NCKiser/kiao/kiao-pcba/kiao-pcba.kicad_pcb

## KiCad design kiao-pcba/kiao-pcba.kicad_pcb (2024-02-06)

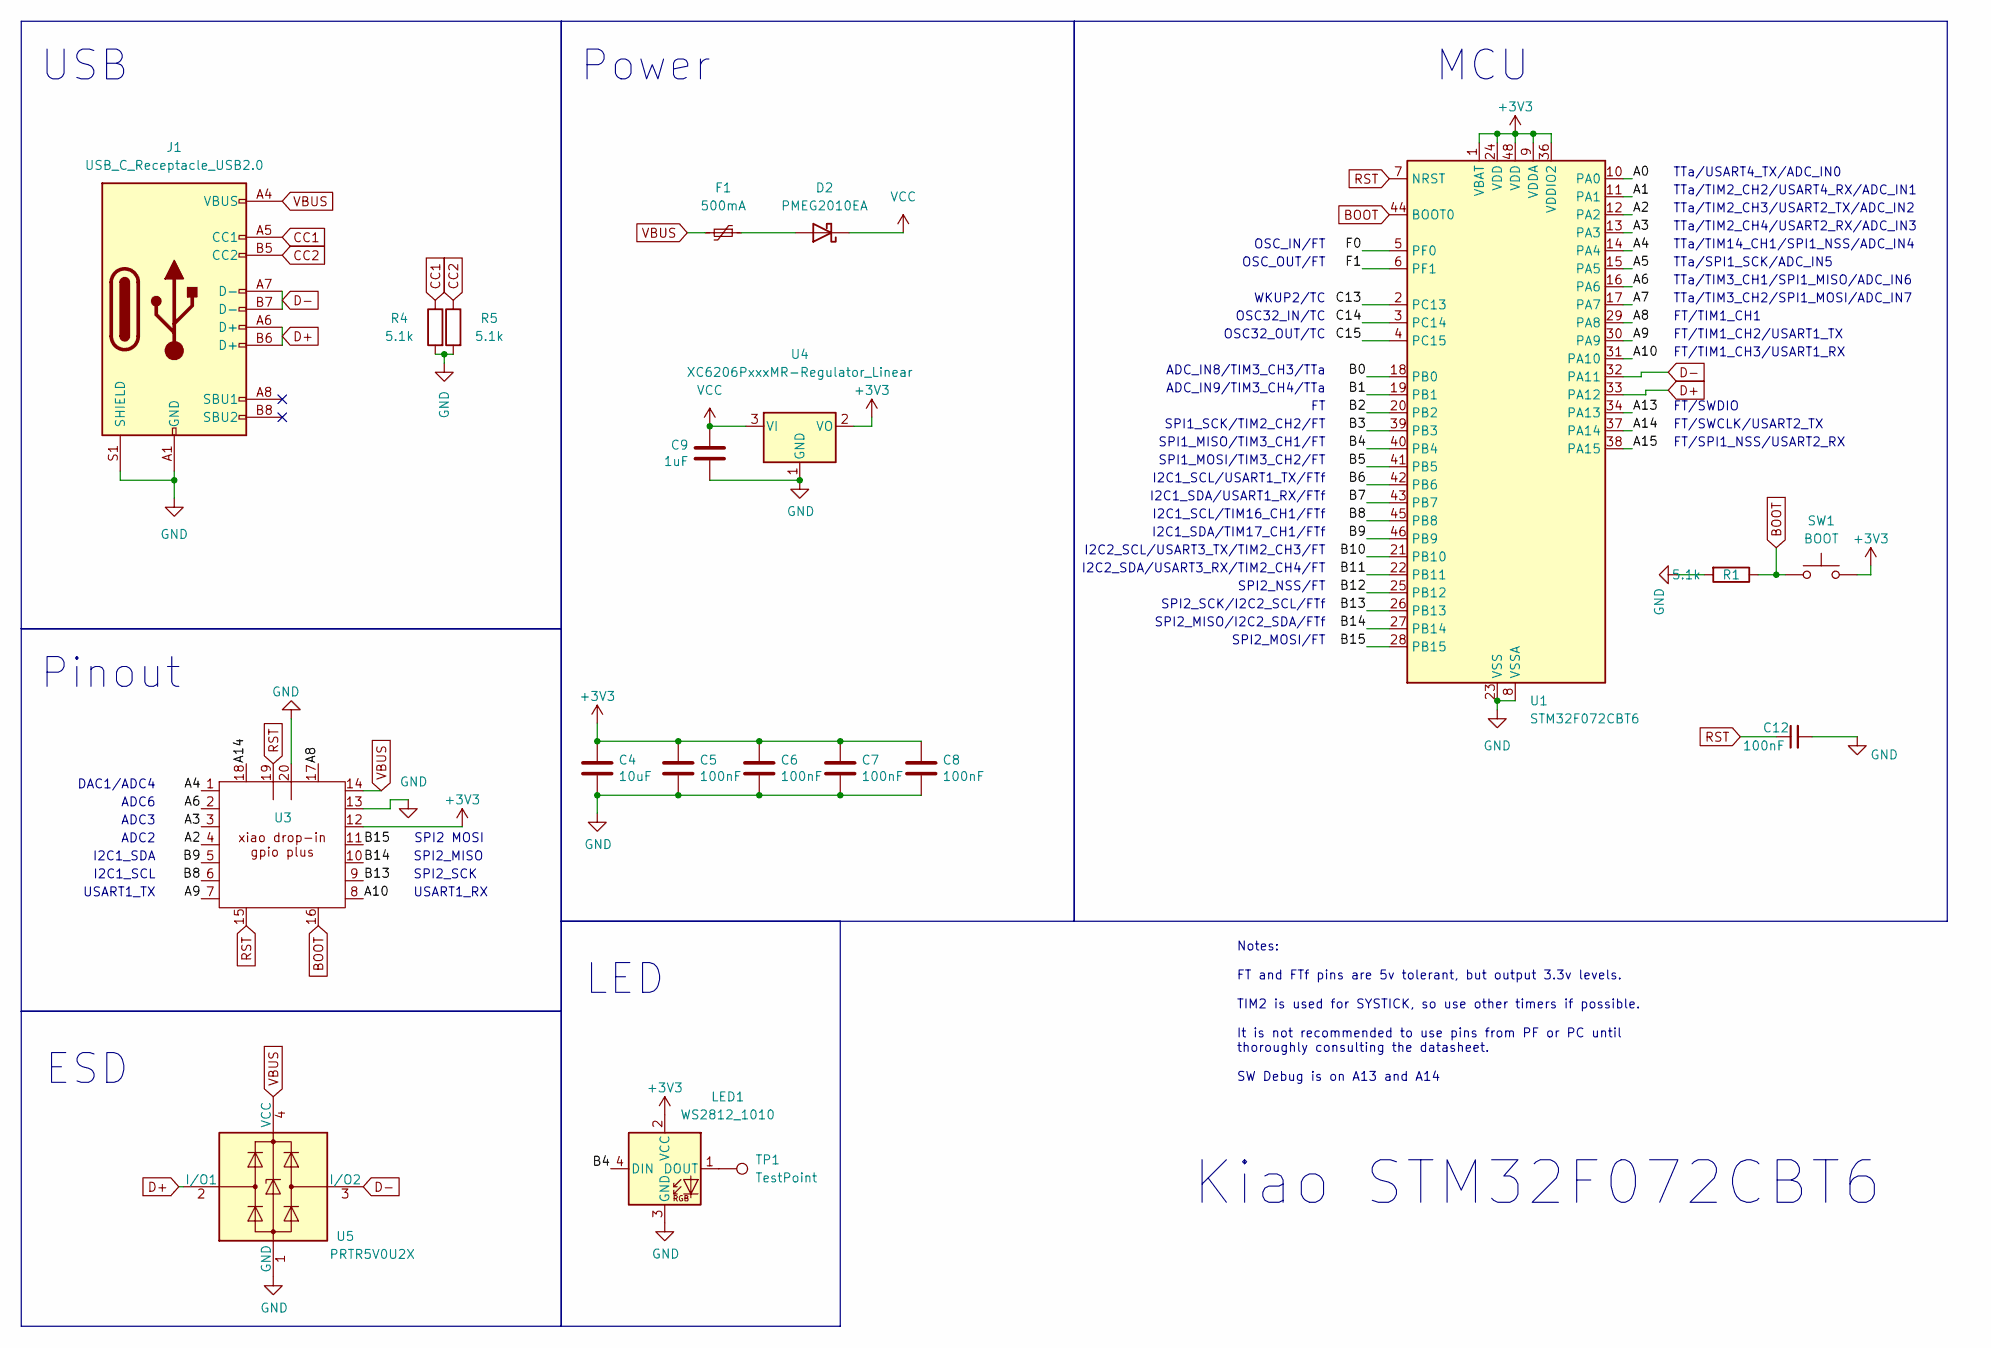
[picture p1: schematic kiao-pcba.kicad_sch]

Parts:
C4: 10uF; C_0402_1005Metric; LCSC C307331
C5, C6, C7, C8, C12: 100nF; C_0402_1005Metric; LCSC C307331
C9: 1uF; C_0402_1005Metric; LCSC C307331
D2: PMEG2010EA; D_0402_1005Metric; LCSC C2837790
F1: 500mA; Fuse_0402_1005Metric; LCSC C210357
J1: USB_C_Receptacle_USB2.0; USB_C_Receptacle_HRO_TYPE-C-31-M-12; JLCPCB_CORRECTION 0; -1.35; 0
LED1: WS2812_1010
R1: 5.1k; R_0402_1005Metric
R4, R5: 5.1k; R_0402_1005Metric; LCSC C25905
SW1: BOOT; SW_Push_SPST_NO_Alps_SKRK; LCSC C115357
TP1: TestPoint; TestPoint_THTPad_D1.0mm_Drill0.5mm
U1: STM32F072CBT6; LQFP-48_7x7mm_P0.5mm; JlcRotOffset 90
U3: xiao_drop-in_gpio_usb_no_cutout; xiao_drop-in_gpio_plus_4_castellated
U4: XC6206PxxxMR-Regulator_Linear; SOT-23; LCSC C5446
U5: PRTR5V0U2X; SOT-143; LCSC C2827688

Connections:
+3V3: C4.1, C5.1, C6.1, C7.1, C8.1, LED1.2 (VCC), SW1.2, U1.1 (VBAT), U1.9 (VDDA), U1.24 (VDD), U1.36 (VDDIO2), U1.48 (VDD), U3.12, U4.2 (VO)
/A0: U1.10 (PA0)
/A1: U1.11 (PA1)
/A2: U1.12 (PA2), U3.4
/A3: U1.13 (PA3), U3.3
/A4: U1.14 (PA4), U3.1
/A5: U1.15 (PA5)
/A6: U1.16 (PA6), U3.2
/A7: U1.17 (PA7)
/A8: U1.29 (PA8), U3.17
/A9: U1.30 (PA9), U3.7
/A10: U1.31 (PA10), U3.8
/A13: U1.34 (PA13)
/A14: U1.37 (PA14), U3.18
/A15: U1.38 (PA15)
/B0: U1.18 (PB0)
/B1: U1.19 (PB1)
/B2: U1.20 (PB2)
/B3: U1.39 (PB3)
/B4: LED1.4 (DIN), U1.40 (PB4)
/B5: U1.41 (PB5)
/B6: U1.42 (PB6)
/B7: U1.43 (PB7)
/B8: U1.45 (PB8), U3.6
/B9: U1.46 (PB9), U3.5
/B10: U1.21 (PB10)
/B11: U1.22 (PB11)
/B12: U1.25 (PB12)
/B13: U1.26 (PB13), U3.9
/B14: U1.27 (PB14), U3.10
/B15: U1.28 (PB15), U3.11
/C13: U1.2 (PC13)
/C14: U1.3 (PC14)
/C15: U1.4 (PC15)
/F0: U1.5 (PF0)
/F1: U1.6 (PF1)
BOOT: R1.1, SW1.1, U1.44 (BOOT0), U3.16
CC1: J1.A5 (CC1), R4.1
CC2: J1.B5 (CC2), R5.1
D+: J1.A6 (D+), J1.B6 (D+), U1.33 (PA12), U5.2 (I/O1)
D-: J1.A7 (D-), J1.B7 (D-), U1.32 (PA11), U5.3 (I/O2)
GND: C4.2, C5.2, C6.2, C7.2, C8.2, C9.2, C12.2, J1.A1 (GND), J1.A12 (GND), J1.B1 (GND), J1.B12 (GND), J1.S1 (SHIELD), LED1.3 (GND), R1.2, R4.2, R5.2, U1.8 (VSSA), U1.23 (VSS), U1.35 (VSS), U1.47 (VSS), U3.13, U3.20, U4.1 (GND), U5.1 (GND)
unnamed: D2.2 (A), F1.1
unnamed: LED1.1 (DOUT), TP1.1
RST: C12.1, U1.7 (NRST), U3.15, U3.19
VBUS: F1.2, J1.A4 (VBUS), J1.A9 (VBUS), J1.B4 (VBUS), J1.B9 (VBUS), U3.14, U5.4 (VCC)
VCC: C9.1, D2.1 (K), U4.3 (VI)

Notes on the sheet:
LED
SPI2_MOSI/FT
I2C1_SDA
TTa/TIM2_CH3/USART2_TX/ADC_IN2
MCU
Kiao STM32F072CBT6
I2C1_SDA/USART1_RX/FTf
DAC1/ADC4
USB
ADC6
SPI2_SCK/I2C2_SCL/FTf
Notes: FT and FTf pins are 5v tolerant, but output 3.3v levels. TIM2 is used for SYSTICK, so use other timers if possible. It is not recommended to use pins from PF or PC until thoroughly consulting the datasheet. SW Debug is on A13 and A14
TTa/TIM3_CH2/SPI1_MOSI/ADC_IN7
FT/SWCLK/USART2_TX
SPI2_NSS/FT
TTa/TIM3_CH1/SPI1_MISO/ADC_IN6
ADC3
SPI2_MISO
ADC_IN9/TIM3_CH4/TTa
I2C1_SCL/TIM16_CH1/FTf
TTa/USART4_TX/ADC_IN0
TTa/TIM14_CH1/SPI1_NSS/ADC_IN4
I2C1_SDA/TIM17_CH1/FTf
TTa/SPI1_SCK/ADC_IN5
WKUP2/TC
OSC_IN/FT
TTa/TIM2_CH4/USART2_RX/ADC_IN3
USART1_TX
SPI2_MISO/I2C2_SDA/FTf
FT/TIM1_CH1
Power
SPI1_MOSI/TIM3_CH2/FT
FT/SWDIO
OSC32_OUT/TC
SPI2_SCK
ESD
TTa/TIM2_CH2/USART4_RX/ADC_IN1
I2C2_SDA/USART3_RX/TIM2_CH4/FT
FT/TIM1_CH2/USART1_TX
SPI1_SCK/TIM2_CH2/FT
SPI2 MOSI
I2C1_SCL/USART1_TX/FTf
USART1_RX
ADC_IN8/TIM3_CH3/TTa
SPI1_MISO/TIM3_CH1/FT
FT/TIM1_CH3/USART1_RX
I2C1_SCL
Pinout
ADC2
FT/SPI1_NSS/USART2_RX
OSC_OUT/FT
I2C2_SCL/USART3_TX/TIM2_CH3/FT
OSC32_IN/TC

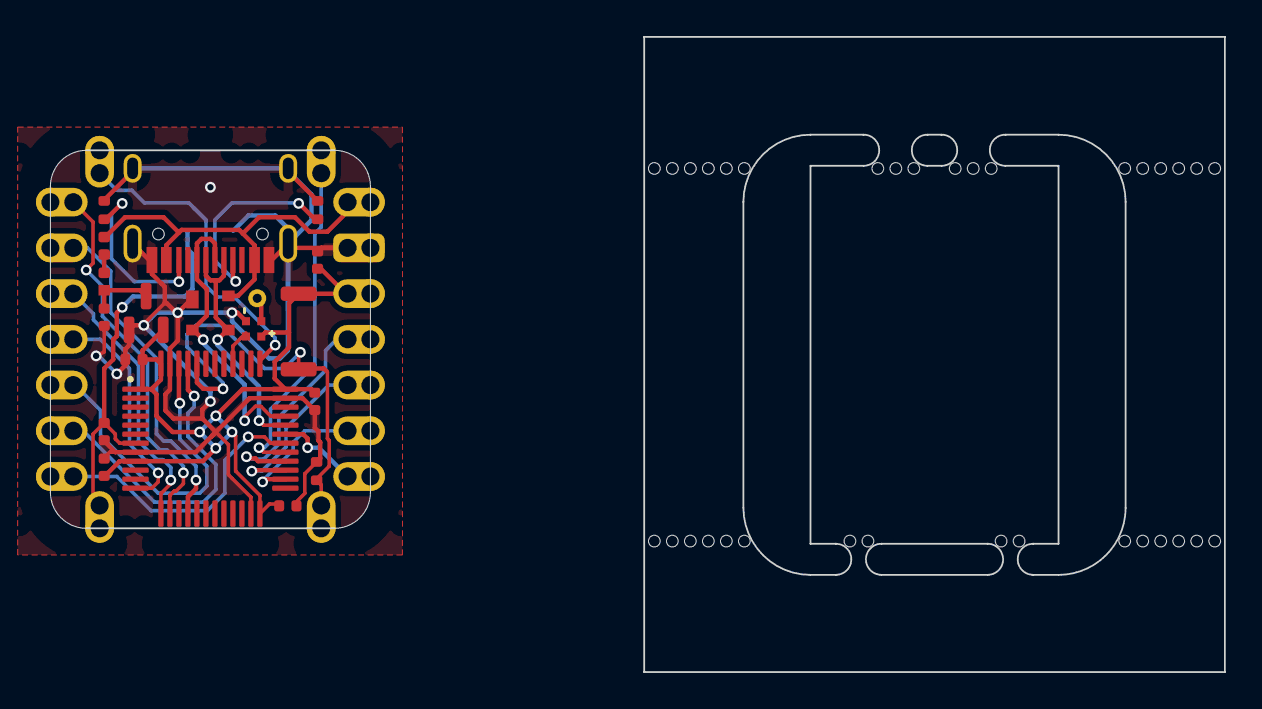
[picture p2: board kiao-pcba.kicad_pcb from above]

Board: 2 copper layers, 17.8 x 21.0 mm, 20 parts (0 on the bottom side), 26 nets.
