NCKiser/kiao/(commit log)

2024-02-04 Changes pinout, half-panel, gerbers. Proto'd
    [bom.csv, designators.csv, kiao-pcba.kicad_pcb, kiao-pcba.kicad_sch, positions.csv]
2024-02-06 separated panelization
    [kiao-pcba.kicad_pcb]
